Szbuli/relay-controller/board/relay_controller.brd

## EAGLE design board/relay_controller.brd (2021-03-14)

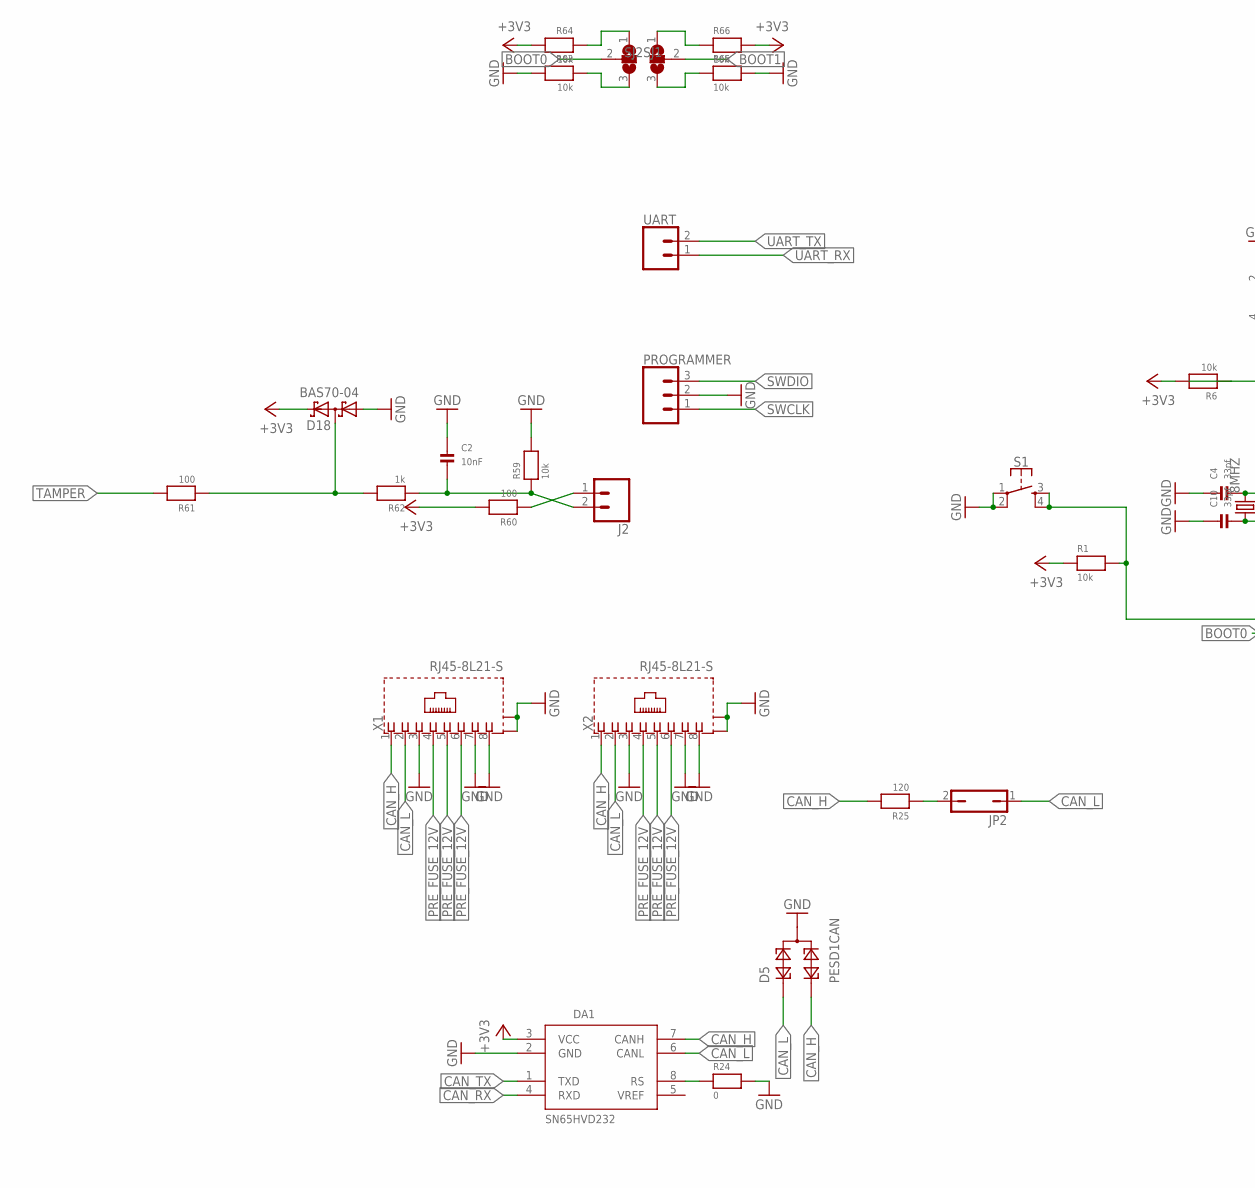
[picture p1: schematic relay_controller.sch, sheet 1, part in row 1, column 1]

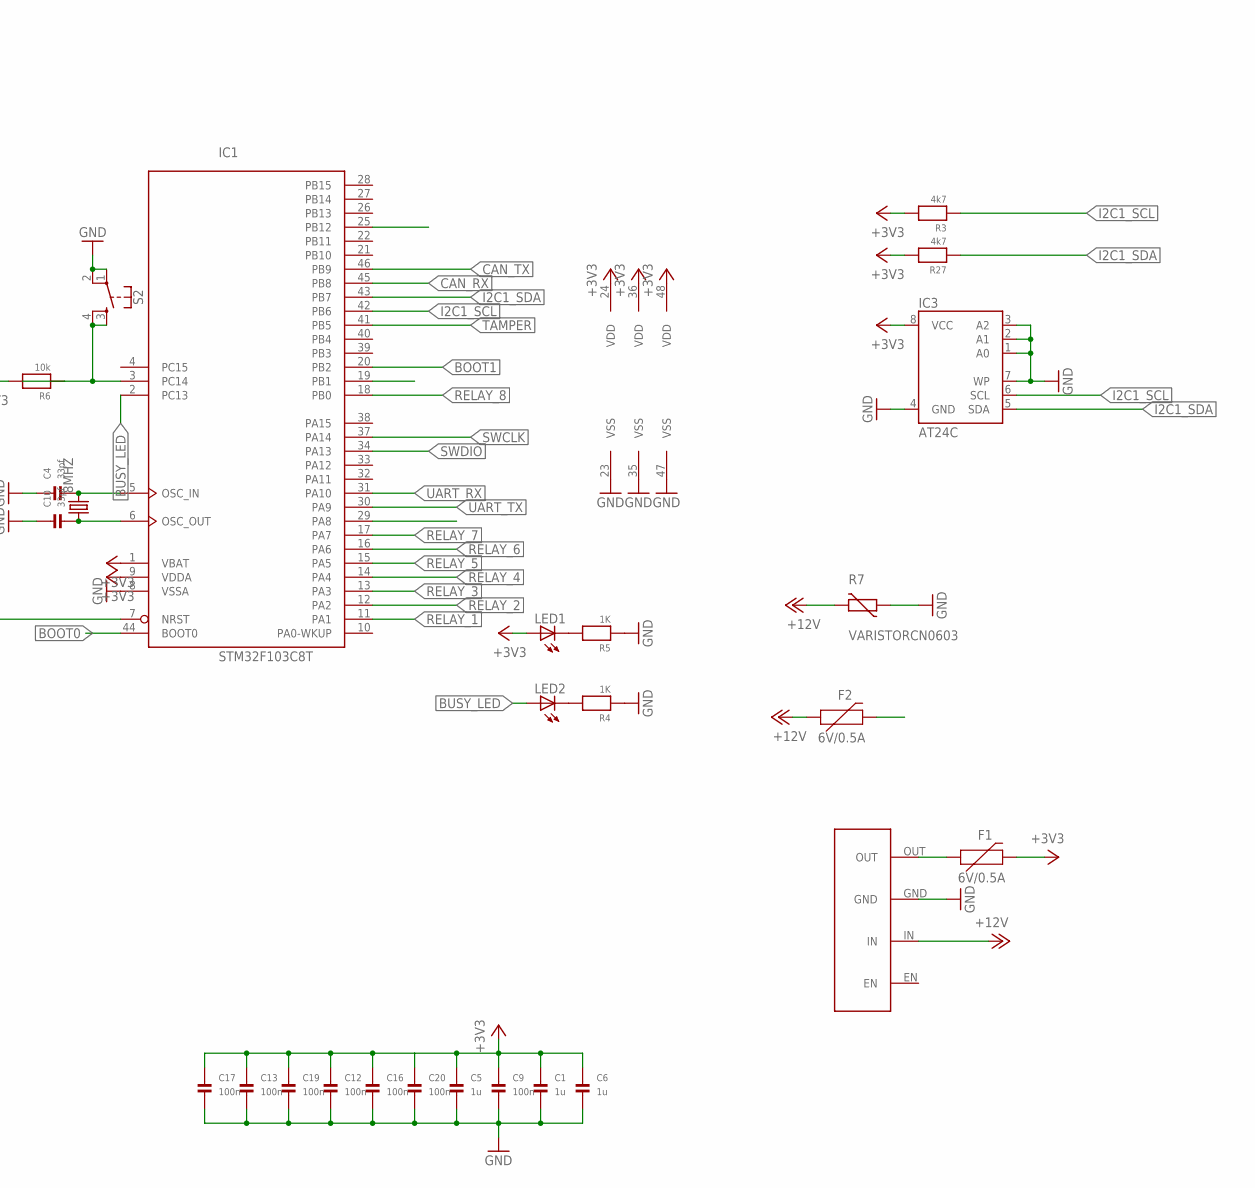
[picture p2: schematic relay_controller.sch, sheet 1, part in row 1, column 2]

Parts:
8MHZ: CRYSTALHC49UP; HC49UP
C1, C5, C6: 1u; 0603
C2: 10nF; 0603
C4, C10: 33pf; 0603
C9, C12, C13, C16, C17, C19, C20: 100n; 0603
D5: PESD1CAN; SOT23
D18: BAS70-04; SOT23
DA1: SN65HVD232; SO08
F1, F2: 6V/0.5A; 1206
IC1: STM32F103C8T; LQFP48
IC3: AT24C; SOIC8
J2: CONN_023.5MM; SCREWTERMINAL-3.5MM-2
JP2: JP1Q; JP1
LED1, LED2: LEDCHIPLED_0805; CHIPLED_0805
PROGRAMMER: CONN_03LOCK; 1X03_LOCK
R1, R6, R59, R63, R64, R65, R66: 10k; 0603
R3, R27: 4k7; 0603
R4, R5: 1K; 0603
R7: VARISTORCN0603; CT/CN0603
R24: 0; 0603
R25: 120; 0603
R60, R61: 100; 0603
R62: 1k; 0603
S1, S2: MOMENTARY-SWITCH-SPST-2-SMD-4.6X2.8MM; TACTILE_SWITCH_SMD_4.6X2.8MM
SJ1, SJ2: SJ2W; SJ_2
U$1: HW-613
UART: CONN_02; 1X02
X1, X2: RJ45-8L21-S; RJ45-SHIELD1

Connections:
+3V3: C1.1, C5.1, C6.1, C9.1, C12.1, C13.1, C16.1, C17.1, C19.1, C20.1, D18.2 (C2), DA1.3 (VCC), F1.2, IC1.1 (VBAT), IC1.9 (VDDA), IC1.24 (VDD), IC1.36 (VDD), IC1.48 (VDD), IC3.8 (VCC), LED1.A, R1.1, R3.2, R6.2, R27.2, R60.2, R64.2, R66.2
+12V: F2.1, R7.2, U$1.IN; also elsewhere on the board
ASDASD: D18.3 (C1A2), R61.1, R62.2
BOOT0: IC1.44 (BOOT0), SJ1.2
BOOT1: IC1.20 (PB2), SJ2.2
BUSY_LED: IC1.2 (PC13), LED2.A
CAN_H: D5.2, DA1.7 (CANH), R25.2, X1.1, X2.1
CAN_L: D5.1, DA1.6 (CANL), JP2.1, X1.2, X2.2
CAN_RX: DA1.4 (RXD), IC1.45 (PB8)
CAN_TX: DA1.1 (TXD), IC1.46 (PB9)
GND: C1.2, C2.1, C4.1, C5.2, C6.2, C9.2, C10.1, C12.2, C13.2, C16.2, C17.2, C19.2, C20.2, D5.3, D18.1 (A1), DA1.2 (GND), IC1.8 (VSSA), IC1.23 (VSS), IC1.35 (VSS), IC1.47 (VSS), IC3.1 (A0), IC3.2 (A1), IC3.3 (A2), IC3.4 (GND), IC3.7 (WP), PROGRAMMER.2, R4.1, R5.1, R7.1, R24.2, R59.2, R63.2, R65.2, S1.1, S1.2, S2.1, S2.2, U$1.GND, X1.3, X1.7, X1.8, X1.S1 (S), X1.S2 (S), X2.3, X2.7, X2.8, X2.S1 (S), X2.S2 (S); also elsewhere on the board
I2C1_SCL: IC1.42 (PB6), IC3.6 (SCL), R3.1
I2C1_SDA: IC1.43 (PB7), IC3.5 (SDA), R27.1
unnamed: 8MHZ.2, C4.2, IC1.5 (OSC_IN)
unnamed: 8MHZ.1, C10.2, IC1.6 (OSC_OUT)
unnamed: F1.1, U$1.OUT
unnamed: C2.2, J2.2, R59.1, R62.1
unnamed: LED1.C, R5.2
unnamed: IC1.3 (PC14), R6.1, S2.3, S2.4
unnamed: LED2.C, R4.2
unnamed: J2.1, R60.1
unnamed: IC1.7 (NRST), R1.2, S1.3, S1.4
unnamed: JP2.2, R25.1
unnamed: DA1.8 (RS), R24.1
unnamed: R66.1, SJ2.1
unnamed: R64.1, SJ1.1
unnamed: R65.1, SJ2.3
unnamed: R63.1, SJ1.3
PRE_FUSE_12V: F2.2, X1.4, X1.5, X1.6, X2.4, X2.5, X2.6
RELAY_1: IC1.11 (PA1); also elsewhere on the board
RELAY_2: IC1.12 (PA2); also elsewhere on the board
RELAY_3: IC1.13 (PA3); also elsewhere on the board
RELAY_4: IC1.14 (PA4); also elsewhere on the board
RELAY_5: IC1.15 (PA5); also elsewhere on the board
RELAY_6: IC1.16 (PA6)
RELAY_7: IC1.17 (PA7)
RELAY_8: IC1.18 (PB0)
RELAY_9: IC1.19 (PB1)
RELAY_12: IC1.25 (PB12)
RELAY_16: IC1.29 (PA8)
SWCLK: IC1.37 (PA14), PROGRAMMER.1
SWDIO: IC1.34 (PA13), PROGRAMMER.3
TAMPER: IC1.41 (PB5), R61.2
UART_RX: IC1.31 (PA10), UART.1
UART_TX: IC1.30 (PA9), UART.2

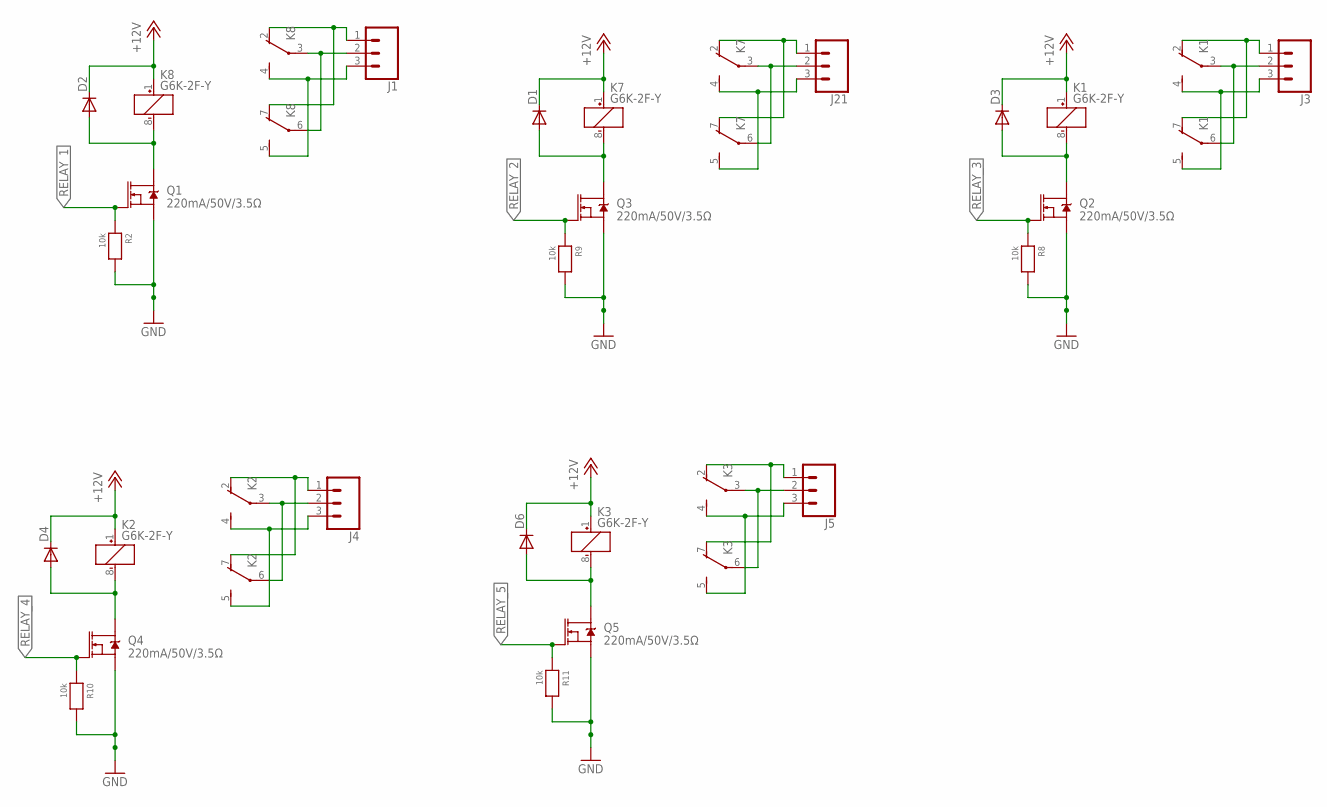
[picture p3: schematic relay_controller.sch, sheet 2]

Parts:
D1, D2, D3, D4, D6: DIODE-DO-214AC; DO-214AC
J1, J3, J4, J5, J21: CONN_03SCREW; SCREWTERMINAL-3.5MM-3
K1, K2, K3, K7, K8: G6K-2F-Y
Q1, Q2, Q3, Q4, Q5: 220mA/50V/3.5Ω; SOT23-3
R2, R8, R9, R10, R11: 10k; 0603

Connections:
+12V: D1.C, D2.C, D3.C, D4.C, D6.C, K1.1 (+), K2.1 (+), K3.1 (+), K7.1 (+), K8.1 (+); also elsewhere on the board
GND: Q1.2 (S), Q2.2 (S), Q3.2 (S), Q4.2 (S), Q5.2 (S), R2.2, R8.2, R9.2, R10.2, R11.2; also elsewhere on the board
unnamed: J21.1, K7.2 (O), K7.7 (O)
unnamed: J1.1, K8.2 (O), K8.7 (O)
unnamed: J21.3, K7.4 (S), K7.5 (S)
unnamed: J21.2, K7.3, K7.6
unnamed: D1.A, K7.8 (-), Q3.3 (D)
unnamed: J1.3, K8.4 (S), K8.5 (S)
unnamed: J1.2, K8.3, K8.6
unnamed: D2.A, K8.8 (-), Q1.3 (D)
unnamed: J3.1, K1.2 (O), K1.7 (O)
unnamed: J3.3, K1.4 (S), K1.5 (S)
unnamed: J3.2, K1.3, K1.6
unnamed: D3.A, K1.8 (-), Q2.3 (D)
unnamed: J4.1, K2.2 (O), K2.7 (O)
unnamed: J4.3, K2.4 (S), K2.5 (S)
unnamed: J4.2, K2.3, K2.6
unnamed: D4.A, K2.8 (-), Q4.3 (D)
unnamed: J5.1, K3.2 (O), K3.7 (O)
unnamed: J5.3, K3.4 (S), K3.5 (S)
unnamed: J5.2, K3.3, K3.6
unnamed: D6.A, K3.8 (-), Q5.3 (D)
RELAY_1: Q1.1 (G), R2.1; also elsewhere on the board
RELAY_2: Q3.1 (G), R9.1; also elsewhere on the board
RELAY_3: Q2.1 (G), R8.1; also elsewhere on the board
RELAY_4: Q4.1 (G), R10.1; also elsewhere on the board
RELAY_5: Q5.1 (G), R11.1; also elsewhere on the board

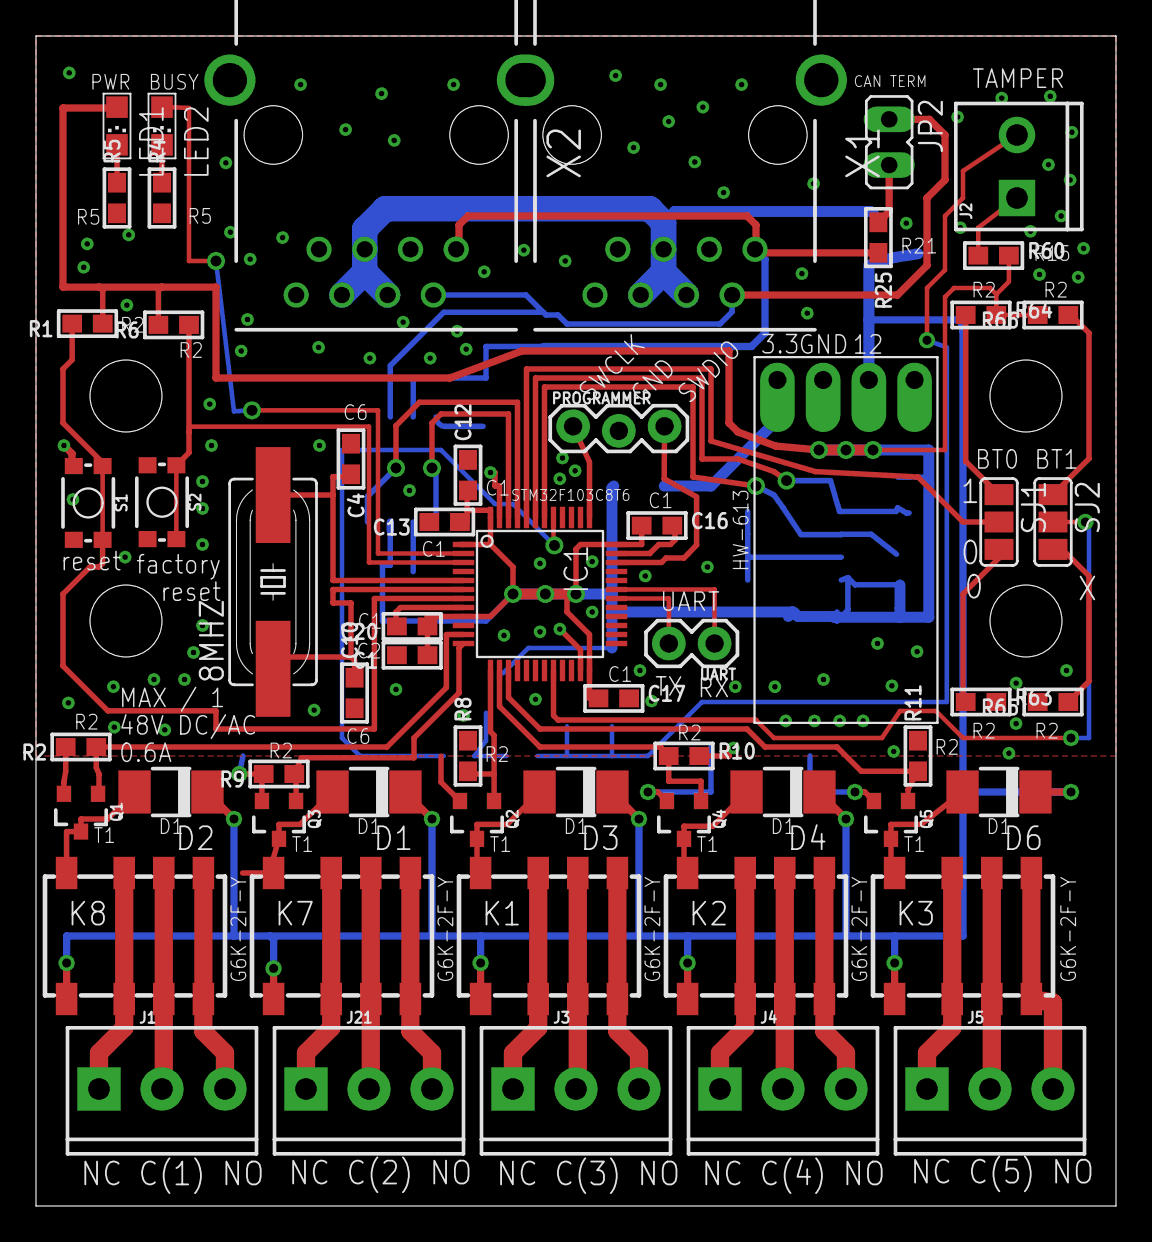
[picture p4: board relay_controller.brd from above]

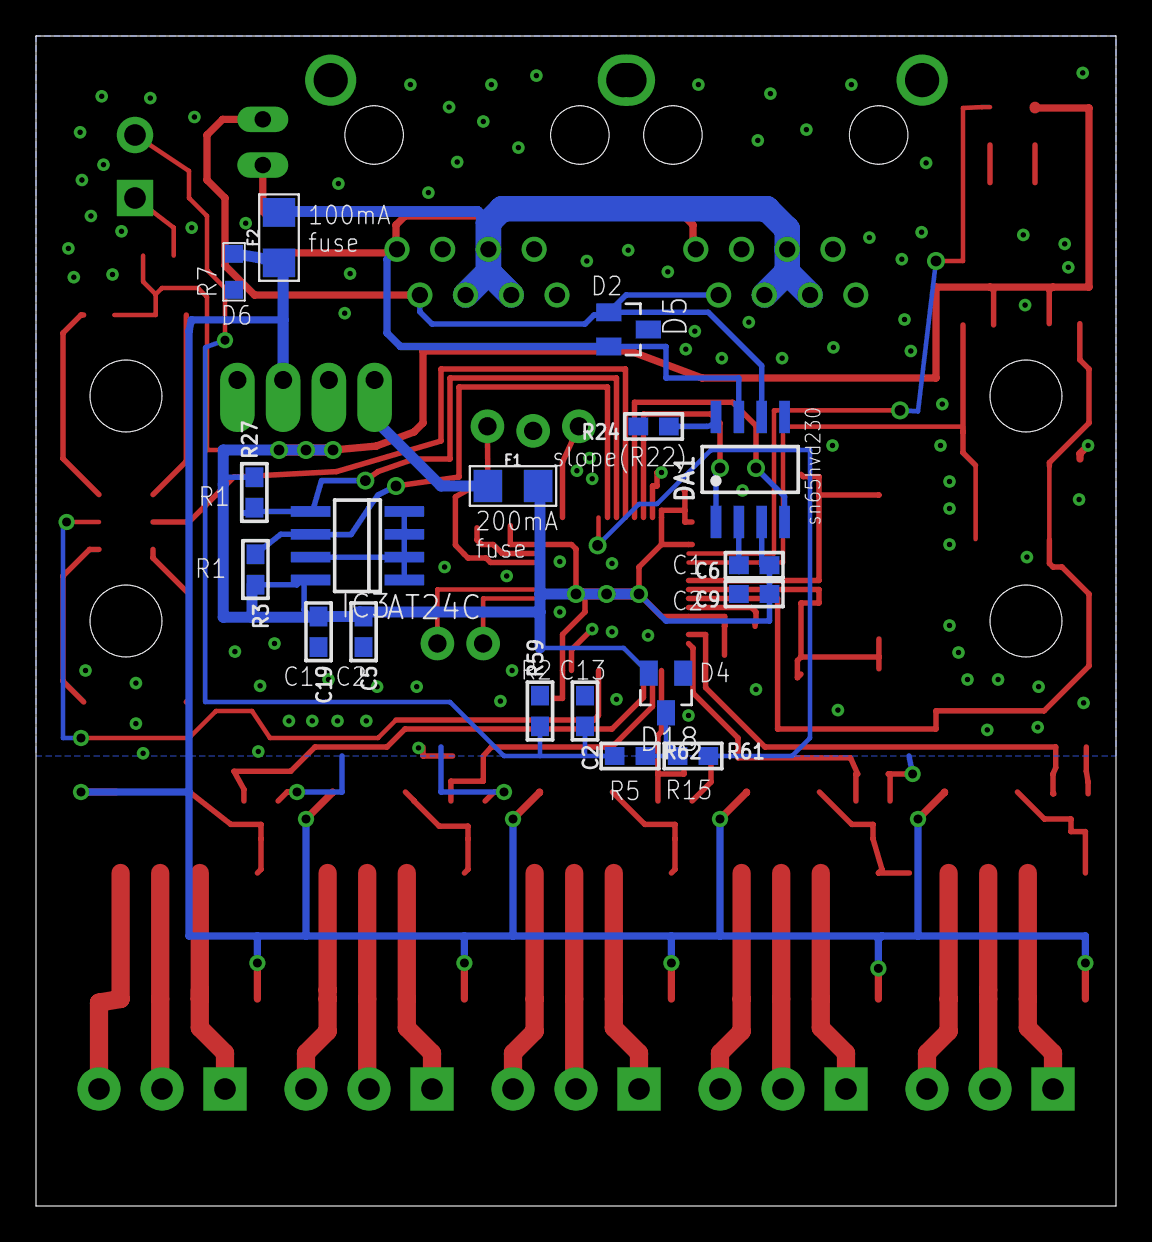
[picture p5: board relay_controller.brd from below]

Board: 2 copper layers, 60.0 x 65.0 mm, 78 parts (18 on the bottom side), 59 nets.

Other parts of the board:
U$2, U$3: C45-DIN-MOUNT-2-HOLE-B
