Szbuli/relay-controller/firmware/bluepill-can-relay-controller/bluepill-can-relay-controller.ioc

Mcu.UserName=STM32F103C8Tx
PA1.GPIO_Label=RELAY_1
PA1.Signal=GPIO_Output
PA10.Signal=USART1_RX
PA13.Signal=SYS_JTMS-SWDIO
PA14.Signal=SYS_JTCK-SWCLK
PA2.GPIO_Label=RELAY_2
PA2.Signal=GPIO_Output
PA3.GPIO_Label=RELAY_3
PA3.Signal=GPIO_Output
PA4.GPIO_Label=RELAY_4
PA4.Signal=GPIO_Output
PA5.GPIO_Label=RELAY_5
PA5.Signal=GPIO_Output
PA9.Signal=USART1_TX
PB5.GPIO_Label=TAMPER
PB5.Signal=GPXTI5
PB6.GPIO_Label=I2C_SCL
PB6.Signal=I2C1_SCL
PB7.GPIO_Label=I2C_SDA
PB7.Signal=I2C1_SDA
PB8.Signal=CAN_RX
PB9.Signal=CAN_TX
PC13-TAMPER-RTC.GPIO_Label=BUSY_LED
PC13-TAMPER-RTC.Signal=GPIO_Output
PC14-OSC32_IN.GPIO_Label=FACTORY_RESET
PC14-OSC32_IN.Signal=GPIO_Input
PD0-OSC_IN.Signal=RCC_OSC_IN
PD1-OSC_OUT.Signal=RCC_OSC_OUT
