Szbuli/relay-controller/firmware/bluepill-can-relay-controller/Inc/main.h

#define BUSY_LED_Pin GPIO_PIN_13
#define BUSY_LED_GPIO_Port GPIOC
#define FACTORY_RESET_Pin GPIO_PIN_14
#define FACTORY_RESET_GPIO_Port GPIOC
#define RELAY_1_Pin GPIO_PIN_1
#define RELAY_1_GPIO_Port GPIOA
#define RELAY_2_Pin GPIO_PIN_2
#define RELAY_2_GPIO_Port GPIOA
#define RELAY_3_Pin GPIO_PIN_3
#define RELAY_3_GPIO_Port GPIOA
#define RELAY_4_Pin GPIO_PIN_4
#define RELAY_4_GPIO_Port GPIOA
#define RELAY_5_Pin GPIO_PIN_5
#define RELAY_5_GPIO_Port GPIOA
#define TAMPER_Pin GPIO_PIN_5
#define TAMPER_GPIO_Port GPIOB
#define TAMPER_EXTI_IRQn EXTI9_5_IRQn
#define I2C_SCL_Pin GPIO_PIN_6
#define I2C_SCL_GPIO_Port GPIOB
#define I2C_SDA_Pin GPIO_PIN_7
#define I2C_SDA_GPIO_Port GPIOB
