Szbuli/relay-controller/firmware/bluepill-can-relay-controller/Inc/config/home_config.h

/*
 * home_config.h
 *
 *  Created on: 2017.05.23.
 *      Author: Szbuli
 */

#ifndef CONFIG_HOME_CONFIG_H_
#define CONFIG_HOME_CONFIG_H_

#include "cmsis_os.h"

#define ADDRESS_DEVICE_ID_PART_0 0
#define ADDRESS_DEVICE_ID_PART_1 1
#define ADDRESS_TAMPER 30
#define ADDRESS_HEARTBEAT 31

#define STM32_UUID_32 ((uint32_t *)0x1FFF7A10)
#define STM32_UUID_16 ((uint16_t *)0x1FFF7A10)

#define VERSION_MAJOR 1
#define VERSION_MINOR 0
#define VERSION_PATCH 0

#define DEVICE_TYPE_ID_ALARM_CONTROLLER 2

typedef struct {
	uint8_t listenForDeviceIdMode;
	uint8_t deviceLoaded;
	uint16_t deviceId;
	uint8_t tamper;
	uint8_t heartbeat;
} HomeConfig;

extern HomeConfig homeConfig;

void checkAndDoFactoryResetIfNeeded();
void readConfigOnStartup();
void factoryReset();
void configureTamper(uint8_t state);
void configureHeartbeat(uint8_t state);

#endif /* CONFIG_HOME_CONFIG_H_ */
