Szbuli/relay-controller/firmware/bluepill-can-relay-controller/Src/config/home_config.c

/*
 * home_config.c
 *
 *  Created on: 2017.05.23.
 *      Author: Szbuli
 */

#include "home_config.h"
#include "can_support.h"
#include "eeprom.h"
#include "can-ids.h"
#include "gpio.h"

HomeConfig homeConfig;

void blinkRapid() {
	HAL_GPIO_WritePin(BUSY_LED_GPIO_Port, BUSY_LED_Pin, GPIO_PIN_RESET);
	osDelay(50);
	HAL_GPIO_WritePin(BUSY_LED_GPIO_Port, BUSY_LED_Pin, GPIO_PIN_SET);
	osDelay(50);
	HAL_GPIO_WritePin(BUSY_LED_GPIO_Port, BUSY_LED_Pin, GPIO_PIN_RESET);
	osDelay(50);
	HAL_GPIO_WritePin(BUSY_LED_GPIO_Port, BUSY_LED_Pin, GPIO_PIN_SET);
	osDelay(50);
	HAL_GPIO_WritePin(BUSY_LED_GPIO_Port, BUSY_LED_Pin, GPIO_PIN_RESET);
}

void checkAndDoFactoryResetIfNeeded() {
	GPIO_PinState factoryResetState = HAL_GPIO_ReadPin(FACTORY_RESET_GPIO_Port, FACTORY_RESET_Pin);
	if (factoryResetState == GPIO_PIN_SET) {
		return;
	}

	osDelay(5000);
	factoryResetState = HAL_GPIO_ReadPin(FACTORY_RESET_GPIO_Port, FACTORY_RESET_Pin);
	if (factoryResetState == GPIO_PIN_SET) {
		HAL_GPIO_WritePin(BUSY_LED_GPIO_Port, BUSY_LED_Pin, GPIO_PIN_RESET);
		return;
	}
	blinkRapid();
	HAL_GPIO_WritePin(BUSY_LED_GPIO_Port, BUSY_LED_Pin, GPIO_PIN_SET);
	factoryReset();
	blinkRapid();
	HAL_NVIC_SystemReset();
}

void readConfigOnStartup() {
	homeConfig.deviceId = readByteEEPROM(ADDRESS_DEVICE_ID_PART_0) | readByteEEPROM(ADDRESS_DEVICE_ID_PART_1) << 8;
	homeConfig.tamper = readByteEEPROM(ADDRESS_TAMPER);
	homeConfig.heartbeat = readByteEEPROM(ADDRESS_HEARTBEAT);
}

void factoryReset() {
	writeByteEEPROM(ADDRESS_DEVICE_ID_PART_0, 0xFF);
	writeByteEEPROM(ADDRESS_DEVICE_ID_PART_1, 0xFF);
	writeByteEEPROM(ADDRESS_TAMPER, 0);
	writeByteEEPROM(ADDRESS_HEARTBEAT, 1);
}

void configureTamper(uint8_t state) {
	writeByteEEPROM(ADDRESS_TAMPER, state);

	osDelay(100);
	HAL_NVIC_SystemReset();
}

void configureHeartbeat(uint8_t state) {
	writeByteEEPROM(ADDRESS_HEARTBEAT, state);

	osDelay(100);
	HAL_NVIC_SystemReset();
}
