Szbuli/relay-controller/(commit log)

2020-05-06 init relay controller board
    [relay_controller.brd, relay_controller.sch]
2020-05-07 add component labels
    [relay_controller.brd]
2020-05-07 update some labels
    [relay_controller.brd]
2020-05-09 add factory reset button
    [relay_controller.brd, relay_controller.sch]
2020-05-09 add tamper, uart
    [relay_controller.brd, relay_controller.sch]
2020-05-13 init fw
    [bluepill.cfg]
2020-06-06 fix tamper interrupt
2020-06-06 fix some labels
    [relay_controller.brd]
2020-06-07 add 3.3v output for relay board
    [relay_controller.brd, relay_controller.sch]
2020-06-07 change default pin state to high
2020-06-10 add 3.3v output
    [relay_controller.brd, relay_controller.sch]
2020-06-12 power over can
    [relay_controller.brd, relay_controller.sch]
2020-06-29 add varistor
    [relay_controller.brd, relay_controller.sch]
2020-07-01 add current limiting resistor
    [relay_controller.brd, relay_controller.sch]
2020-07-13 refresh libs
    [relay_controller.brd]
2020-07-18 increase size for 5mm inputs
    [relay_controller.brd, relay_controller.sch]
2020-07-18 jumpers for boot mode
    [relay_controller.brd, relay_controller.sch]
2020-07-18 change to solderable boot jumper
    [relay_controller.brd, relay_controller.sch]
2020-07-18 value for current limiting resistor
    [relay_controller.brd, relay_controller.sch]
2020-11-23 change 16 driver pin to 5 relay output (g6k-2f-y)
    [relay_controller.brd, relay_controller.sch]
2020-11-24 DRC check fixes
    [relay_controller.brd]
2020-12-03 add default boot mode label
    [relay_controller.brd]
2021-01-08 fix label
    [relay_controller.brd]
2021-01-09 Cubeide migration (#1)
    * init migration
    * update to new relay
    * update header dates
    [bluepill.cfg]
2021-02-28 Feature/ha auto discovery (#2)
    * init
    * init canbus before auto discovery
    * fix auto discovery state
    * wait on queue when tx mailbox is full
    [can-ids.h, can_support.c, ha_auto_discovery.c, home_config.h]
2021-02-28 add default value for slope resistor
    [relay_controller.brd]
2021-03-05 update labels
    [relay_controller.brd]
2021-03-11 more distance between rj45 connectors
    [relay_controller.brd, relay_controller.sch]
2021-03-13 change to packages with place drawing
    [relay_controller.brd, relay_controller.sch]
2021-03-13 remove unused fuse
    [relay_controller.brd, relay_controller.sch]
2021-03-13 change pull down to 10k
    [relay_controller.brd]
2021-03-14 fix labels and place orientation
    [relay_controller.brd, relay_controller.sch]
2021-07-11 add run cfg
    [bluepill-can-relay-controller.cfg]
2021-07-11 can tx error log
    [can_support.c]
